qylinqingxuan/stm32-weather-clock/README.md

# STM32 智能天气时钟

一块 1.8 寸屏上的桌面天气时钟：联网校时、实况天气、室内温湿度、6 页生活指数轮播，右下角还养了一只会在深夜睡觉的桌宠。

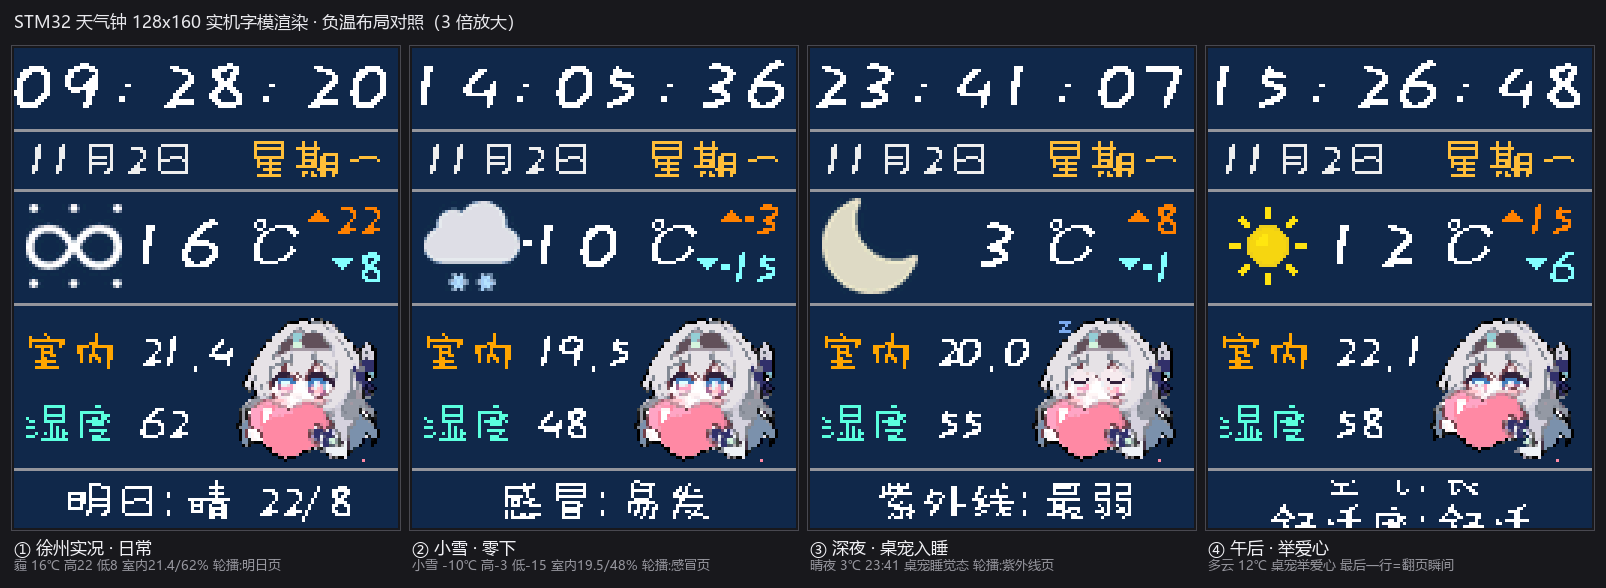
[picture p1: docs/ui_preview.png]
UI 预览


*（真字模渲染图，四屏各一个卖点：日常实况 / 零下小雪的 3px 小负号 / 深夜桌宠入睡 / 桌宠举爱心——第④屏最后一行是 6 页轮播上下滚动的翻页瞬间。实物为 128×160 ST7735 彩屏）*

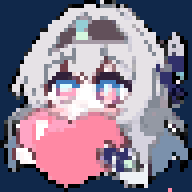
[picture p2: docs/pet.gif]
桌宠动画


*（桌宠实机动画：呼吸 → 眨眼 → 举爱心 → 深夜入睡；48×48 真帧数据逐帧渲染）*

## 功能

- **时钟**：RTC（外部 32.768kHz 晶振）计数器当 Unix 秒，Hinnant 算法换算日期；开机自动联网校时，未校准时显示 `--:--:--` 而不是 1970 年
- **天气**：心知天气 API，实况（10 分钟周期）+ 3 天预报 + 生活指数；自写流式 JSON 解析器，不建 DOM、不引库
- **显示**：21 个 32×32 天气图标按官方码表归并；负温 3px 小负号；最后一行 6 页轮播（明日天气 / 降水概率 / 感冒 / 紫外线 / 空气 / 舒适度），每页 4 秒、17 帧上下滚动（旧页上滑出新页从下推入）
- **室内环境**：DHT11 两段式采样（拉低即返回、下一圈再读），1 秒一次，不阻塞
- **桌宠**：常驻呼吸 + 随机眨眼 + 随机举爱心 + 整点必举 + 22:00~07:00 睡觉；入睡时背光 1 秒渐暗到 20%，醒来渐亮
- **亮度**：PB10 复用为 TIM2_CH3 PWM 调光，零阻塞改占空比

## 技术要点

| 设计 | 说明 |
|---|---|
| 全状态机架构 | 网络取数（11 状态）、温湿度采样、轮播、桌宠、背光渐变全部是"每圈推进一步"的状态机；主循环 12ms 一圈跑到底，没有任何一处阻塞等待——卡一下，秒就跳 |
| `ESP_POLL_GAP` | 非阻塞化后串口扫描快了上百倍，模块还没回完上一条 AT 就被塞下一条命令，会回 `busy p...` 或直接吞掉命令。把阻塞版固有的 0~10ms 盲区显式留成 10ms 常数，连续请求才稳定——本项目踩得最深的一个坑 |
| 流式 JSON 解析 | 一遍遍历、就地取值，不建 DOM、不回退，SRAM 占用与 JSON 结构无关 |
| 补丁帧动画 | ST7735 只能写不能读，没法"读回背景再画"，所以桌宠每帧只描述相对上一帧变化的矩形：收尾一帧只重画约 114 像素，而不是整只 48×48 的 2304 像素 |
| 时基正确性 | 32 位毫秒计数每 59652ms（约 1 分钟）回绕一次，拿它存"未来时刻"必出定时 bug；累加式 `delay_uptime()` 49.7 天才回绕，定时场景统一用它 |
| 图标生成管线 | 官方 PNG → LANCZOS 缩放 → 按背景色量化 16 色 → 4bit 索引，脚本直接生成 C 数组，21 个图标零手绘 |
| 资源占用 | Code+RO ≈ 61KB / 128KB flash，RW+ZI ≈ 7.4KB / 20KB RAM，全程静态分配无 malloc |

## 硬件

| 部件 | 型号 / 参数 | 接口 |
|---|---|---|
| MCU | STM32F103C8T6，72MHz | — |
| 屏 | ST7735 1.8 寸 128×160 RGB565（只写不读） | SPI（软件片选） |
| WiFi | ESP-01S（AT 固件） | USART2 115200 |
| 温湿度 | DHT11 | 单总线 GPIO |
| 时钟 | 外部 LSE 32.768kHz | RTC |
| 调试 | USART1 9600（可关） | PA9/PA10 |

### 接线表

| 模块 | 模块引脚 | STM32 引脚 | 说明 |
|---|---|---|---|
| ST7735 屏 | SCL | PA5 | SPI1 SCK |
| | SDA / MOSI | PA7 | SPI1 MOSI；屏只写，MISO 不接 |
| | CS | PA4 | |
| | DC (RS) | PB1 | |
| | RES | PB0 | |
| | BL | PB10 | TIM2_CH3 PWM 调光（全重映射到 PB10） |
| ESP-01S | RX | PA2 | USART2 TX，与模块 RX 交叉 |
| | TX | PA3 | USART2 RX |
| | CH_PD | 3.3V | 使能脚拉高 |
| DHT11 | DATA | PA6 | 单总线；裸传感器需约 4.7k 上拉，模块版一般自带 |
| USB-TTL（调试） | RXD | PA9 | USART1 TX，9600 |
| | TXD | PA10 | USART1 RX |

所有模块均为 3.3V 供电（ESP-01S 接 5V 会烧）。

## 编译

1. **环境**：Keil MDK-ARM + ARM Compiler 5。MDK 5.36 及更早自带 AC5；5.37 起需要在 Pack Installer 里单独装 Compiler Version 5。标准外设库已随仓库附带，无需另装；
2. **先建密钥文件**（不做这步编译过不了）：复制 `程序/App/secrets_example.h` 为同目录的 `secrets.h`，填入 WiFi 名、WiFi 密码和 [心知天气](https://www.seniverse.com/) 免费注册的 API key；城市默认徐州拼音 `xuzhou`，可改；
3. 打开 `程序/weather_clock.uvprojx`，Rebuild，判据看 `0 Error(s)`；
4. 烧录：ST-Link 接 SWD，Keil 里点 Load。

## 目录

```
程序/
├── App/        业务层: 取数调度、屏幕数据加工、UI、桌宠、JSON 解析
├── Hardware/   驱动层: ESP8266 状态机、ST7735、DHT11、PWM 调光
├── System/     时基: RTC、delay（含 49.7 天不回绕的 uptime）
├── Assets/     字库、天气图标、桌宠帧数据（脚本生成）
├── user/       main.c 主循环
└── FWlib/ CMSIS/  标准外设库
```

更详细的踩坑笔记见 [docs/notes.md](docs/notes.md)。

## FAQ（设计取舍）

- **Q：开机为什么要等将近一分半？** A：开机要完成联网、校时和三类数据的首取，ESP-01S 的 AT 握手本身就慢；开机画面有九步进度条，但每步要多久无法预测。
- **Q：天气为什么不是实时的？** A：心知免费版实况数据本身约 15 分钟才更新、滞后 30~60 分钟；本地已经 10 分钟轮询一次，比数据源还快。
- **Q：23 项生活指数为什么只显示 4 项？** A：屏幕只有 128×160，6 页轮播已经排满，只留感冒 / 紫外线 / 空气 / 舒适度这四个与出行最相关的。
- **Q：时间冒号为什么不闪？** A：秒位本身在走；做闪烁要给逐位判重刷新加半秒翻转逻辑，收益配不上复杂度。
- **Q：室内湿度最低只显示 20、温度没有负数？** A：DHT11 量程就是 0-50℃ / 20-85%RH，室内场景足够；如有低温仓库等需求，换 DHT22 即可（采样接口不变，只改解码约 10 行）。
- **Q：空气明明很好却显示"较差"？** A：心知生活指数里的"空气"是**空气污染扩散指数**（今天利于污染物扩散还是积聚），不是空气污染指数（AQI）；后者是心知付费版接口，免费版拿不到。

## 数据来源

- 天气/生活指数：[心知天气 API](https://docs.seniverse.com/)
- 舒适度：自算国标舒适度公式（温度、湿度、风速三输入，定点 ×100 运算）
- 图标：[心知官方图标包](https://docs.seniverse.com/api/start/code.html) 转换生成

## License

[MIT](LICENSE)
