qylinqingxuan/stm32-weather-clock/程序/Hardware/Lcd_Driver.h

#ifndef __LCD_DRIVER_H__
#define __LCD_DRIVER_H__

#define RED  	0xf800
#define GREEN	0x07e0
#define BLUE 	0x001f
#define WHITE	0xffff
#define BLACK	0x0000
#define YELLOW  0xFFE0
#define SKY_BULE 0x045B
#define GRAY0   0xEF7D
#define GRAY1   0x8410
#define GRAY2   0x4208

#define LCD_CTRLA   	  	GPIOA
#define LCD_CTRLB   	  	GPIOB

#define LCD_SCL        	GPIO_Pin_5
#define LCD_SDA        	GPIO_Pin_7
#define LCD_CS        	GPIO_Pin_4

#define LCD_LED        	GPIO_Pin_10
#define LCD_RS         	GPIO_Pin_1
#define LCD_RST     	GPIO_Pin_0

#define	LCD_SCL_SET  	LCD_CTRLA->BSRR=LCD_SCL
#define	LCD_SDA_SET  	LCD_CTRLA->BSRR=LCD_SDA
#define	LCD_CS_SET  	LCD_CTRLA->BSRR=LCD_CS

#define	LCD_LED_SET  	LCD_CTRLB->BSRR=LCD_LED
#define	LCD_RS_SET  	LCD_CTRLB->BSRR=LCD_RS
#define	LCD_RST_SET  	LCD_CTRLB->BSRR=LCD_RST

#define	LCD_SCL_CLR  	LCD_CTRLA->BRR=LCD_SCL
#define	LCD_SDA_CLR  	LCD_CTRLA->BRR=LCD_SDA
#define	LCD_CS_CLR  	LCD_CTRLA->BRR=LCD_CS

#define	LCD_LED_CLR  	LCD_CTRLB->BRR=LCD_LED
#define	LCD_RST_CLR  	LCD_CTRLB->BRR=LCD_RST
#define	LCD_RS_CLR  	LCD_CTRLB->BRR=LCD_RS

#define LCD_DATAOUT(x) LCD_DATA->ODR=x;
#define LCD_DATAIN     LCD_DATA->IDR;

#define LCD_WR_DATA(data){\
LCD_RS_SET;\
LCD_CS_CLR;\
LCD_DATAOUT(data);\
LCD_WR_CLR;\
LCD_WR_SET;\
LCD_CS_SET;\
}

void LCD_GPIO_Init(void);
void Lcd_WriteIndex(u8 Index);
void Lcd_WriteData(u8 Data);
void Lcd_WriteReg(u8 Index,u8 Data);
void Lcd_Reset(void);
void Lcd_Init(void);
void LCD_SetBacklight(u8 percent);
void Lcd_Clear(u16 Color);
void Lcd_SetXY(u16 x,u16 y);
void Lcd_DrawPoint(u16 x,u16 y,u16 Data);
unsigned int Lcd_ReadPoint(u16 x,u16 y);
void Lcd_SetRegion(u16 x_start,u16 y_start,u16 x_end,u16 y_end);
void LCD_WriteData_16Bit(u16 Data);

#endif
