qylinqingxuan/stm32-weather-clock/程序/App/secrets_example.h

#ifndef __SECRETS_H
#define __SECRETS_H

/* == 只需要改这个文件 ==
 * 把本文件复制一份, 改名为 secrets.h (放在同目录), 填好下面 3 个值就能跑:
 *   1. WIFI_SSID      你家 WiFi 名字
 *   2. WIFI_PASSWORD  WiFi 密码
 *   3. WEATHER_KEY    心知天气密钥, seniverse.com 免费注册就有
 * secrets.h 已被 .gitignore 排除, 不会提交到仓库, 密码密钥不会泄露 */

#define WIFI_SSID       ""
#define WIFI_PASSWORD   ""
#define WEATHER_KEY     ""
#define WEATHER_CITY    "xuzhou"   /* 城市拼音, 可不改 */

#endif
