qylinqingxuan/stm32-weather-clock/(commit log)

2026-11-05 STM32 weather clock: bare-metal, fully non-blocking state-machine firmware
    - STM32F103C8T6 + ST7735 1.8' TFT + ESP-01S + DHT11
    - All-peripheral state machines (network/DHT11/scroll/pet/backlight), zero blocking in main loop
    - Hand-rolled streaming JSON parser, no third-party libs
    - 7 host-side test suites (310+ assertions) run on PC without hardware
    - 21 weather icon buckets generated from official PNGs via script pipeline
2026-11-05 docs: render last row as vertical-scroll mid-frame in UI preview
